mwasacz/led-cube/PCB/LedCube.sch.png

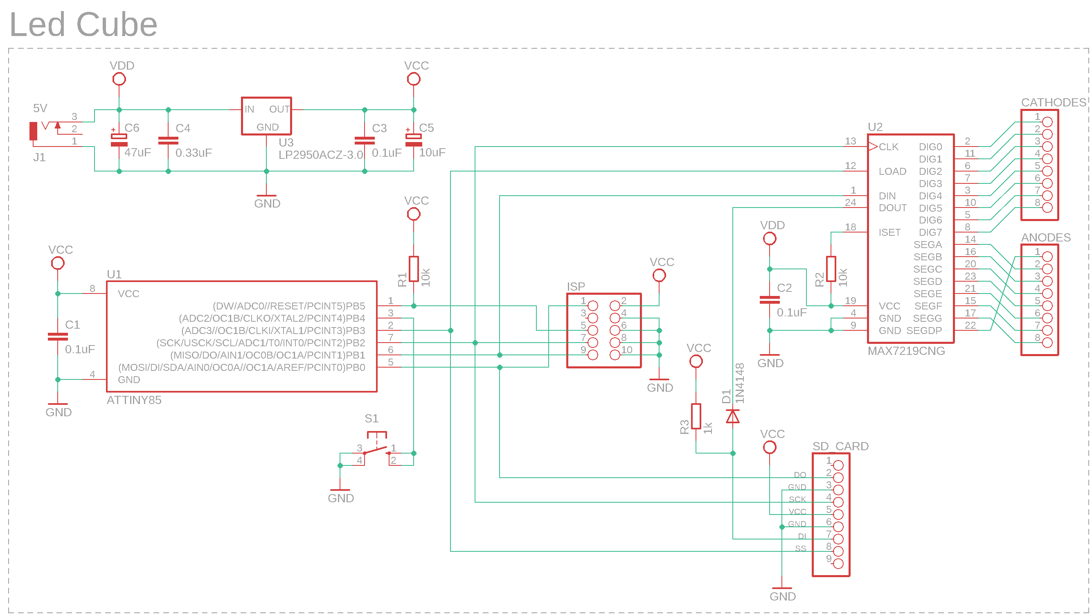
PCB/LedCube.sch.png
