mwasacz/led-cube/Photos/Led Cube 1.jpg

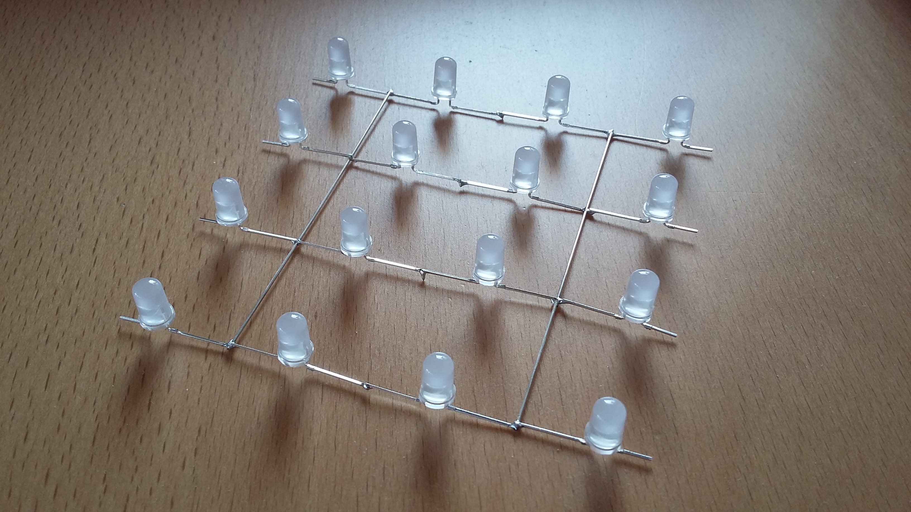
Photos/Led Cube 1.jpg
