mwasacz/led-cube/Photos/Led Cube 2.jpg

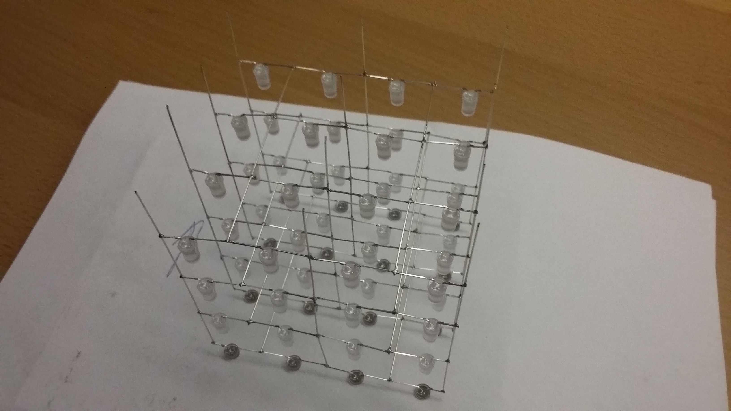
Photos/Led Cube 2.jpg
