mwasacz/led-cube/Photos/Led Cube 3.jpg

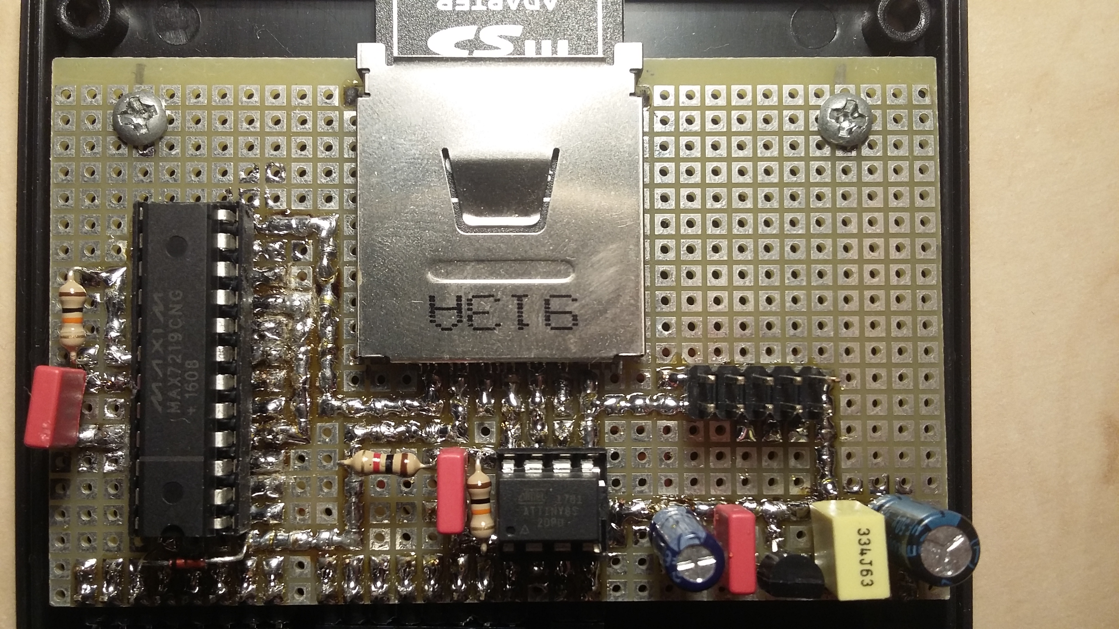
Photos/Led Cube 3.jpg
