mwasacz/led-cube/Photos/Led Cube 4.jpg

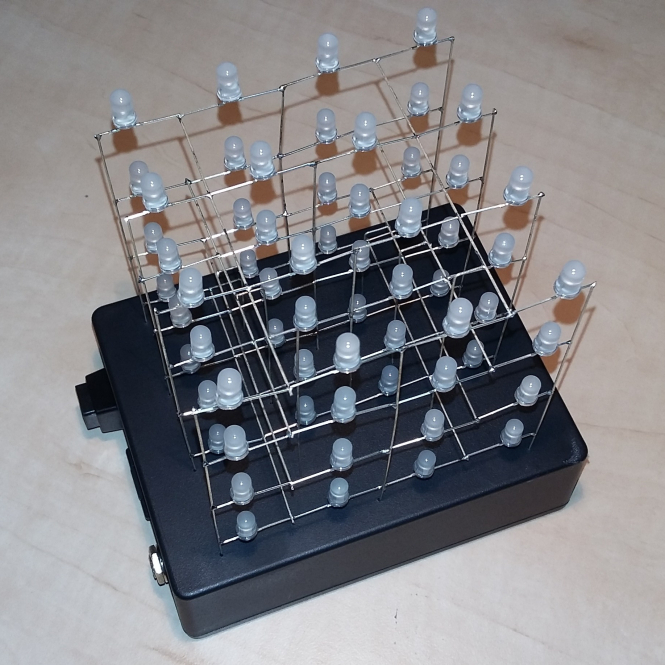
Photos/Led Cube 4.jpg
