mwasacz/led-cube/Photos/Led Cube 6.jpg

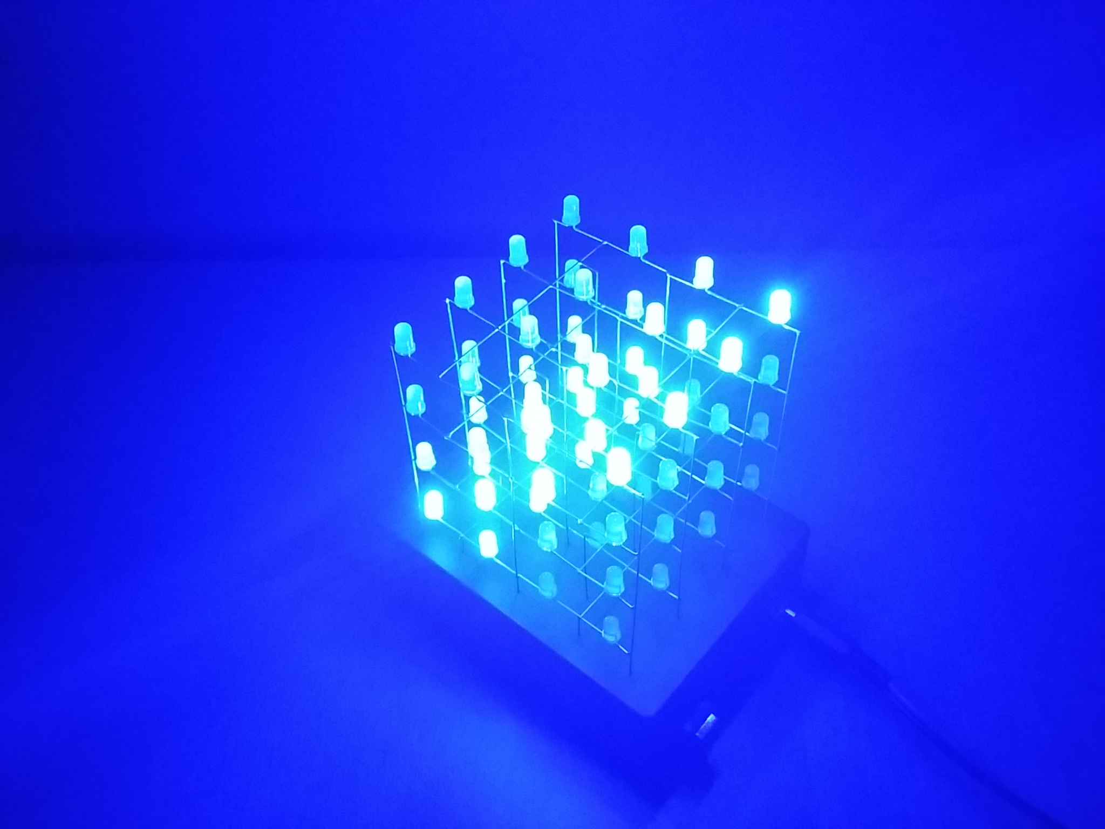
Photos/Led Cube 6.jpg
