mwasacz/led-cube/PCB/LedCube.sch

## EAGLE design PCB/LedCube.sch (2020-09-03)

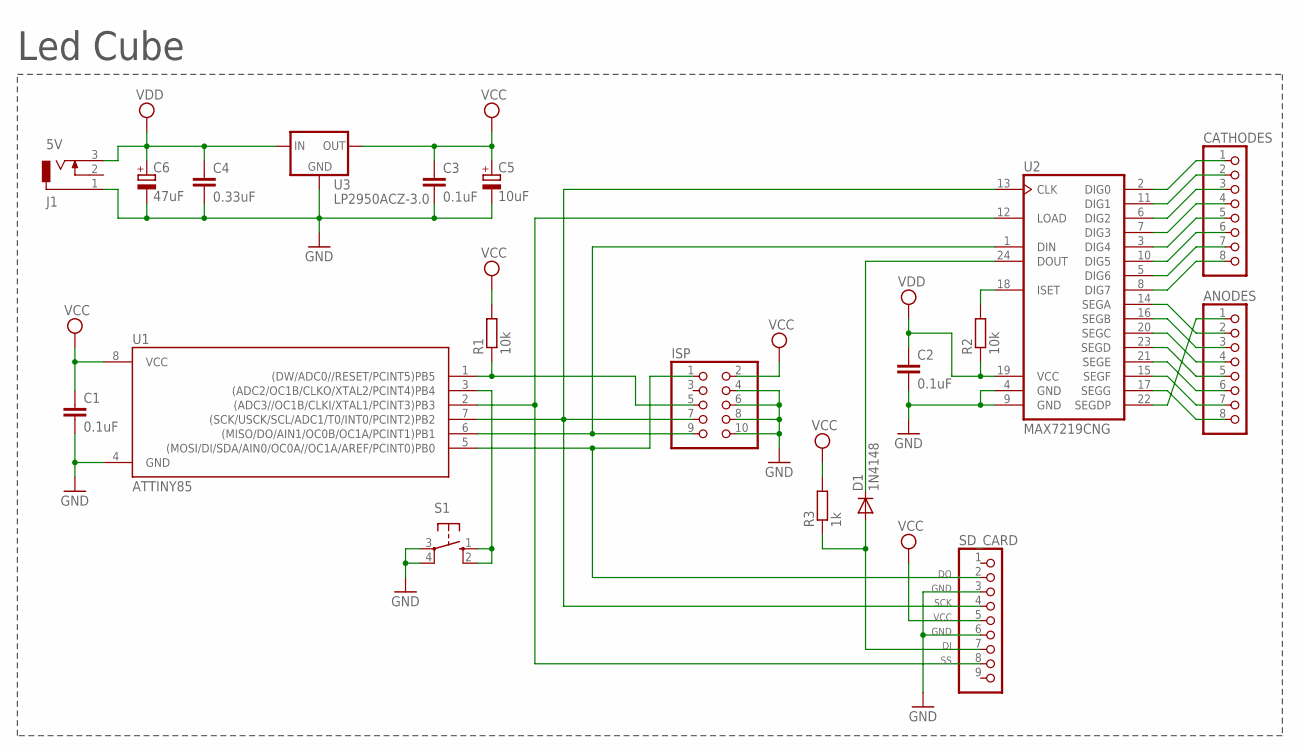
[picture p8: schematic LedCube.sch]

Parts:
ANODES: PINHD-1X8/90; 1X08/90
C1, C2, C3: 0.1uF; C050-025X075
C4: 0.33uF; C050-045X075
C5: 10uF; E2,5-5
C6: 47uF; E2,5-6
CATHODES: PINHD-1X8/90; 1X08/90
D1: 1N4148; D-5
ISP: PINHD-2X5; 2X05
J1: 5V; DCJ0202
R1, R2: 10k; 0207/7
R3: 1k; 0207/7
S1: 10-XX; B3F-10XX
SD_CARD: PINHD-1X9/90; 1X09/90
U1: ATTINY85; DIL08
U2: MAX7219CNG; DIL24-3
U3: LP2950ACZ-3.0; TO92

Connections:
GND: C1.2, C2.2, C3.2, C4.2, C5.-, C6.-, ISP.4, ISP.6, ISP.8, ISP.10, J1.1, S1.3, S1.4 (P1), U1.4 (GND), U2.4 (GND), U2.9 (GND), U3.2 (GND)
unnamed: ISP.1, SD_CARD.2, U1.5 ((MOSI/DI/SDA/AIN0/OC0A//OC1A/AREF/PCINT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)
unnamed: SD_CARD.3, SD_CARD.6
unnamed: ISP.7, SD_CARD.4, U1.7 ((SCK/USCK/SCL/ADC1/T0/INT0/PCINT2)PB2), U2.13 (CLK)
unnamed: ISP.9, U1.6 ((MISO/DO/AIN1/OC0B/OC1A/PCINT1)PB1), U2.1 (DIN)
unnamed: SD_CARD.8, U1.2 ((ADC3//OC1B/CLKI/XTAL1/PCINT3)PB3), U2.12 (LOAD)
unnamed: ISP.5, R1.1, U1.1 ((DW/ADC0//RESET/PCINT5)PB5)
unnamed: D1.C, U2.24 (DOUT)
unnamed: D1.A, R3.1, SD_CARD.7
unnamed: S1.1 (S), S1.2 (S1), U1.3 ((ADC2/OC1B/CLKO/XTAL2/PCINT4)PB4)
unnamed: R2.2, U2.18 (ISET)
unnamed: CATHODES.1, U2.2 (DIG0)
unnamed: CATHODES.2, U2.11 (DIG1)
unnamed: CATHODES.3, U2.6 (DIG2)
unnamed: CATHODES.4, U2.7 (DIG3)
unnamed: CATHODES.5, U2.3 (DIG4)
unnamed: CATHODES.6, U2.10 (DIG5)
unnamed: CATHODES.7, U2.5 (DIG6)
unnamed: CATHODES.8, U2.8 (DIG7)
unnamed: ANODES.2, U2.14 (SEGA)
unnamed: ANODES.3, U2.16 (SEGB)
unnamed: ANODES.4, U2.20 (SEGC)
unnamed: ANODES.5, U2.23 (SEGD)
unnamed: ANODES.6, U2.21 (SEGE)
unnamed: ANODES.7, U2.15 (SEGF)
unnamed: ANODES.8, U2.17 (SEGG)
unnamed: ANODES.1, U2.22 (SEGDP)
VCC: C1.1, C3.1, C5.+, ISP.2, R1.2, R3.2, SD_CARD.5, U1.8 (VCC), U3.1 (OUT)
VDD: C2.1, C4.1, C6.+, J1.3, R2.1, U2.19 (VCC), U3.3 (IN)

Notes on the sheet:
GND
VCC
SCK
Led Cube
